mostafaaabedia-tech/earthquake/firmware/earthquake_esp32/earthquake_esp32.ino

/*
  ============================================================================
   QuakeGuard v2  —  Earthquake Detection & Building Evacuation  (ESP32 + MPU6050)
  ============================================================================
   When the MPU6050 senses an earthquake:
     • both buzzers sound (siren)          • the warning LED turns on
     • the servo opens the exit door       • the relay turns on the emergency light
     • the event goes to Firebase and the GitHub web page (QuakeGuard dashboard)
     • optional: a Telegram and/or ntfy.sh message is sent to your phone

   Detection (v2)
     STA/LTA trigger, as used by real seismographs: the 1-second average of the
     vibration (STA) is compared with the 30-second background level (LTA).
     An alarm needs:  ratio >= trigger  AND  vibration >= minimum g
                      for at least the minimum duration (rejects door slams).
     Very strong shaking or fast rotation (gyroscope) also triggers it.

   Behaviour
     MONITORING -> earthquake, or dangerous air (MQ-2 / MQ-135) -> ALARM
     ALARM      -> calm for the quiet time                     -> HOLD
                   (buzzers off; LED, door and light stay on so people can leave)
     ALARM/HOLD -> reset button or "Reset alarm" on the page   -> MONITORING
     After a real earthquake, a 24-hour AFTERSHOCK WATCH lowers the threshold.

   The web page can change the detection settings, run tests, calibrate the
   sensor and end the aftershock watch. All of it is read from Firebase.

   The alarm runs on core 1 and never waits for the internet.
   Wi-Fi, Firebase and alerts run on core 0.

   Libraries: ESP32Servo (Kevin Harrington), U8g2 (oliver) for the OLED.   Board: "ESP32 Dev Module".
  ============================================================================
*/

#include <WiFi.h>
#include <WiFiClientSecure.h>
#include <HTTPClient.h>
#include <Wire.h>
#include <ESP32Servo.h>
#include <math.h>
#include <U8g2lib.h>
#include <WebServer.h>
#include <ESPmDNS.h>
#include <Preferences.h>
#include <BLEDevice.h>
#include <BLEServer.h>
#include <BLE2902.h>

// ============================ USER SETTINGS =================================
// Wi-Fi: easiest is the web page -> Settings -> "Set up Wi-Fi by Bluetooth".
// The name and password are then saved in the ESP32 and used after every restart.
// You can still type them here instead (used only when nothing is saved).
// To forget the saved Wi-Fi: hold the RESET button while powering on.
// IMPORTANT: Arduino IDE -> Tools -> Partition Scheme -> "Huge APP (3MB No OTA/1MB SPIFFS)"
const char* WIFI_SSID     = "YOUR_WIFI_NAME";
const char* WIFI_PASSWORD = "YOUR_WIFI_PASSWORD";
const unsigned long BLE_OFF_AFTER_MS = 300000;   // Bluetooth turns off 5 min after Wi-Fi connects (frees memory)

// Firebase Realtime Database URL, without a trailing slash
const char* FIREBASE_URL  = "https://quakeguard-earthquake-default-rtdb.europe-west1.firebasedatabase.app";
const char* FIREBASE_AUTH = "";            // database secret, or empty (see README)

// One database path per floor. Floor 1 = "/earthquake", floor 2 = "/floor2"...
// It must match the "path" of the floor in the web page's config.js.
const char* DB_PATH       = "/earthquake";
const char* FLOOR_NAME    = "Floor 1";

// ---------------- Optional phone alerts (leave empty to switch off) --------
// Telegram: create a bot with @BotFather, press "Start" on it, then put the
// bot token and your chat id here (see README).
const char* TELEGRAM_BOT_TOKEN = "";
const char* TELEGRAM_CHAT_ID   = "";
// ntfy.sh: install the ntfy app and subscribe to a long, secret topic name.
const char* NTFY_TOPIC         = "";

// ------------------------------ Pins ---------------------------------------
const int PIN_SDA        = 21;   // MPU6050 SDA
const int PIN_SCL        = 22;   // MPU6050 SCL
const int PIN_BUZZER_1   = 25;   // active buzzer 1
const int PIN_BUZZER_2   = 26;   // active buzzer 2
const int PIN_LED        = 27;   // warning LED (through 220 ohm resistor)
const int PIN_SERVO      = 13;   // door servo signal
const int PIN_RELAY      = 14;   // relay IN (emergency / corridor light)
const int PIN_RESET_BTN  = 4;    // push button to GND
const int PIN_MQ2        = 34;   // MQ-2  AO  (LPG + smoke)   through a divider 5V -> 3.3V
const int PIN_MQ135      = 35;   // MQ-135 AO (CO2 / bad air) through a divider 5V -> 3.3V

const bool AIR_SENSORS_INSTALLED = true;  // MQ-2 + MQ-135 fitted (false = earthquake only)
const bool RELAY_ACTIVE_LOW     = true;   // your relay: LOW = ON, HIGH = OFF (tested with the relay test sketch)
const bool RELAY_BOOT_TEST      = true;   // relay test at power-up, so you can see it works
const int  RELAY_TEST_TIMES     = 3;      // how many ON/OFF clicks (1 s ON, 1 s OFF each)
// AUTO relay: only for a STRONG earthquake, and only for a while.
//   relayMinG  : shaking must reach this peak (g) before the light turns on (0.06 g = intensity V)
//   relayHold  : the light turns OFF this many seconds after the shaking stops
// Both can also be changed on the web page (Settings -> Detector settings).

const int DOOR_CLOSED_ANGLE = 0;
const int DOOR_OPEN_ANGLE   = 90;

// Default detection settings. The web page can change them (Settings tab).
struct Settings {
  float    minG;       // minimum vibration for an earthquake (g)
  float    staTrig;    // STA/LTA trigger ratio
  float    staDetrig;  // STA/LTA detrigger ratio
  float    gyroDps;    // rotation that also counts as shaking (deg/s)
  uint32_t minDurMs;   // shaking must last this long (ms)
  uint32_t quietMs;    // calm time before buzzers stop (ms)
  float    lpgLimit;   // LPG estimate (ppm) for a gas alarm
  float    smokeLimit; // smoke estimate (ppm)
  float    co2Limit;   // CO2 estimate (ppm)
  float    relayMinG;  // light relay: minimum peak shaking (g)
  uint32_t relayHoldMs;// light relay: stays on this long after the alarm ends
};
Settings cfg = { 0.03f, 3.0f, 1.5f, 25.0f, 800, 15000, 600.0f, 300.0f, 1500.0f, 0.06f, 20000 };

const unsigned long TEST_MS          = 6000;          // test alarm length
const unsigned long RESET_IGNORE_MS  = 2000;          // ignore shaking after reset
const unsigned long DOOR_IGNORE_MS   = 1500;          // ignore shaking while servo moves
const unsigned long MAX_QUAKE_MS     = 120000;        // buzzers stop after 2 min anyway
const unsigned long AFTERSHOCK_MS    = 24UL * 3600000UL; // 24 h aftershock watch
const float         AFTERSHOCK_FACTOR = 0.7f;         // threshold x0.7 during the watch
const unsigned long GAS_WARMUP_MS    = 60000;         // MQ sensor heater warm-up
const unsigned long GAS_CONFIRM_MS   = 2000;
const unsigned long CONFIG_PERIOD_MS = 15000;         // read settings from Firebase

// ------------------------------ OLED ---------------------------------------
// I2C OLED on the same pins as the MPU6050 (SDA 21, SCL 22). Pick your model:
//   1 = 0.96" SSD1306 128x64   2 = 1.3" SH1106 128x64
//   3 = 1.5" SH1107 128x128 (most blue 4-pin boards)
//   4 = 1.5" SH1107 128x128, other type: use it if the picture is shifted or cut with 3
#define OLED_MODEL 3
const bool OLED_ENABLED = true;      // false if no OLED is connected
const unsigned long OLED_PAGE_MS = 5000;   // time per page while monitoring

const bool DEBUG_SERIAL = true;
const char* FW_VERSION  = "2.1";

// Name on the local network: http://quakeguard.local (floor 2: "quakeguard-2" ...)
const char* MDNS_NAME   = "quakeguard";
// ============================================================================

// MPU6050
const uint8_t MPU_ADDR = 0x68;
const float ACCEL_LSB_PER_G  = 16384.0f;   // +/-2 g
const float GYRO_LSB_PER_DPS = 131.0f;     // +/-250 deg/s

const unsigned long SAMPLE_PERIOD_MS = 10;  // 100 Hz
const unsigned long TRACE_WINDOW_MS  = 100; // 10 seismograph points per second
const float STA_ALPHA     = 1.0f / 100.0f;  // 1 s at 100 Hz
const float LTA_ALPHA     = 1.0f / 3000.0f; // 30 s at 100 Hz
const float NOISE_FLOOR_G = 0.002f;         // MPU6050 noise floor

enum State : uint8_t { ST_CALIBRATING = 0, ST_MONITOR, ST_ALARM, ST_HOLD };
const char* STATE_NAMES[] = { "CALIBRATING", "MONITORING", "ALARM", "HOLD" };
enum Kind : uint8_t { K_QUAKE = 0, K_FIRE = 1 };

// --------------------------- Shared data ------------------------------------
portMUX_TYPE dataMux = portMUX_INITIALIZER_UNLOCKED;

struct LiveData {
  State state;
  bool  quake, fire, test, latched;
  float shake, gyro, sta, ratio, peak, peakAll, tilt;
  float lpg, smoke, co2, airRatio;
  int   mq2Raw, mq135Raw;
  bool  gasWarm, silenced, buzzer, led, light, doorOpen, sensorOk;
  uint32_t quakes, fires, aftershocks;
  long  watchLeftS;
};
LiveData live = {};

const int TRACE_LEN = 64;
float    traceRing[TRACE_LEN];
uint32_t traceSeq = 0;

// Event messages: sensor loop -> network task
struct EvMsg { uint8_t type; uint8_t kind; bool test; float peak; float dur; float lpg, smoke, co2; };
enum { EV_START = 0, EV_END = 1 };
const int EVQ_LEN = 16;
EvMsg    evq[EVQ_LEN];
volatile uint32_t evHead = 0;

volatile uint32_t resetCount = 0;

// Commands from the web page
volatile bool cmdReset = false, cmdTest = false, cmdTestFire = false;
volatile bool cmdCalibrate = false, cmdEndWatch = false, cmdSilence = false;
volatile int  cmdRelay = -1;          // new relay mode from the page / Serial / local page

// Light relay mode: AUTO = on during an alarm (normal), ON / OFF = forced,
// TEST = 2 s ON, 2 s OFF, exactly like the relay test sketch.
enum RelayMode : uint8_t { RM_AUTO = 0, RM_ON, RM_OFF, RM_TEST };
const char* RELAY_MODES[] = { "auto", "on", "off", "test" };
volatile RelayMode relayMode = RM_AUTO;
volatile bool relayOn = false;

// --------------------------- Sensor state -----------------------------------
Servo doorServo;
#if OLED_MODEL == 2
U8G2_SH1106_128X64_NONAME_F_HW_I2C oled(U8G2_R0, U8X8_PIN_NONE);
#elif OLED_MODEL == 3
U8G2_SH1107_SEEED_128X128_F_HW_I2C oled(U8G2_R0, U8X8_PIN_NONE);
#elif OLED_MODEL == 4
U8G2_SH1107_128X128_F_HW_I2C oled(U8G2_R0, U8X8_PIN_NONE);
#else
U8G2_SSD1306_128X64_NONAME_F_HW_I2C oled(U8G2_R0, U8X8_PIN_NONE);
#endif
bool oledOk = false;
volatile bool cloudOk = false;       // last Firebase upload worked
void oledCalib(int pct);             // drawn while calibrating
void pushWave(float v);
float baseX = 0, baseY = 0, baseZ = 1;          // current gravity vector
float calX = 0, calY = 0, calZ = 1;             // gravity at calibration (tilt reference)
float gyroOffX = 0, gyroOffY = 0, gyroOffZ = 0;
float shakeAvg = 0, gyroAvg = 0, shakeFast = 0;
float sta = 0, lta = NOISE_FLOOR_G;
bool  sensorOk = false;
bool  doorIsOpen = false;

bool quakeActive = false, fireActive = false, testActive = false, latched = false;
uint8_t testKind = K_QUAKE;
unsigned long trigStartMs = 0, quakeStartMs = 0, lastShakeMs = 0;
unsigned long fireCondMs = 0, fireStartMs = 0, lastFireMs = 0;
unsigned long testStartMs = 0, testEndMs = 0;
unsigned long ignoreUntilMs = 0, watchUntilMs = 0;
float quakePeak = 0, peakAll = 0;
float lpg = 0, smoke = 0, co2 = 400, airRatio = 0;      // air quality estimates (ppm)
int   mq2Raw = 0, mq135Raw = 0;
float peakLpg = 0, peakSmoke = 0, peakCo2 = 0;          // worst air during a gas alarm
bool  silenced = false;                                 // buzzers silenced from the page
bool  lastWasFire = false;                              // cause of the last real alarm (for the OLED)
uint32_t quakeCount = 0, fireCount = 0, aftershockCount = 0;
float windowMax = 0;
unsigned long windowStartMs = 0;

// ============================================================================
//                                MPU6050
// ============================================================================
void mpuWrite(uint8_t reg, uint8_t val) {
  Wire.beginTransmission(MPU_ADDR);
  Wire.write(reg);
  Wire.write(val);
  Wire.endTransmission();
}

bool mpuBegin() {
  Wire.begin(PIN_SDA, PIN_SCL);
  Wire.setClock(400000);
  Wire.beginTransmission(MPU_ADDR);
  if (Wire.endTransmission() != 0) return false;
  mpuWrite(0x6B, 0x00);  // wake up
  delay(100);
  mpuWrite(0x1A, 0x03);  // low-pass filter ~44 Hz
  mpuWrite(0x1B, 0x00);  // gyro +/-250 deg/s
  mpuWrite(0x1C, 0x00);  // accel +/-2 g
  return true;
}

bool mpuRead(float& ax, float& ay, float& az, float& gx, float& gy, float& gz) {
  Wire.beginTransmission(MPU_ADDR);
  Wire.write(0x3B);
  if (Wire.endTransmission(false) != 0) return false;
  if (Wire.requestFrom((int)MPU_ADDR, 14) != 14) return false;
  int16_t raw[7];
  for (int i = 0; i < 7; i++) raw[i] = (int16_t)((Wire.read() << 8) | Wire.read());
  ax = raw[0] / ACCEL_LSB_PER_G;  ay = raw[1] / ACCEL_LSB_PER_G;  az = raw[2] / ACCEL_LSB_PER_G;
  gx = raw[4] / GYRO_LSB_PER_DPS; gy = raw[5] / GYRO_LSB_PER_DPS; gz = raw[6] / GYRO_LSB_PER_DPS;
  return true;
}

// Keep the sensor still for about 2 seconds.
void calibrate() {
  portENTER_CRITICAL(&dataMux); live.state = ST_CALIBRATING; portEXIT_CRITICAL(&dataMux);
  Serial.println("Calibrating... keep the sensor still.");
  for (int attempt = 0; attempt < 5; attempt++) {
    const int N = 200;
    static float bx[N], by[N], bz[N];
    float sx = 0, sy = 0, sz = 0, sgx = 0, sgy = 0, sgz = 0;
    int good = 0;
    for (int i = 0; i < N; i++) {
      float x, y, z, gx, gy, gz;
      if (mpuRead(x, y, z, gx, gy, gz)) {
        bx[good] = x; by[good] = y; bz[good] = z;
        sx += x; sy += y; sz += z; sgx += gx; sgy += gy; sgz += gz;
        good++;
      }
      digitalWrite(PIN_LED, (i / 20) % 2);
      if (i % 20 == 0) oledCalib(i * 100 / N);
      delay(SAMPLE_PERIOD_MS);
    }
    if (good < N / 2) continue;
    baseX = sx / good; baseY = sy / good; baseZ = sz / good;
    gyroOffX = sgx / good; gyroOffY = sgy / good; gyroOffZ = sgz / good;
    float noise = 0;
    for (int i = 0; i < good; i++) {
      float dx = bx[i] - baseX, dy = by[i] - baseY, dz = bz[i] - baseZ;
      noise += sqrtf(dx * dx + dy * dy + dz * dz);
    }
    noise /= good;
    Serial.printf("Calibration noise: %.4f g\n", noise);
    lta = fmaxf(noise, NOISE_FLOOR_G);
    if (noise < 0.02f) break;
    Serial.println("Too much movement, calibrating again...");
  }
  calX = baseX; calY = baseY; calZ = baseZ;
  digitalWrite(PIN_LED, LOW);
  shakeAvg = gyroAvg = shakeFast = 0;
  sta = 0;
}

float tiltDegrees() {
  float n1 = sqrtf(calX * calX + calY * calY + calZ * calZ);
  float n2 = sqrtf(baseX * baseX + baseY * baseY + baseZ * baseZ);
  if (n1 < 0.1f || n2 < 0.1f) return 0;
  float c = (calX * baseX + calY * baseY + calZ * baseZ) / (n1 * n2);
  c = fminf(1.0f, fmaxf(-1.0f, c));
  return acosf(c) * 57.2958f;
}

// Modified Mercalli intensity from peak acceleration (Worden et al. 2012)
float mmiFromG(float g) {
  float L = log10f(fmaxf(g * 980.665f, 0.01f));
  float m = (L <= 1.57f) ? 1.78f + 1.55f * L : -1.60f + 3.70f * L;
  return fminf(10.0f, fmaxf(1.0f, m));
}
const char* ROMAN[] = { "I", "I", "II", "III", "IV", "V", "VI", "VII", "VIII", "IX", "X" };

// ============================================================================
//                               Outputs
// ============================================================================
// Same as the relay test sketch: active-low relay -> digitalWrite(LOW) = ON, digitalWrite(HIGH) = OFF
void setRelay(bool on) {
  if (RELAY_ACTIVE_LOW) digitalWrite(PIN_RELAY, on ? LOW : HIGH);
  else                  digitalWrite(PIN_RELAY, on ? HIGH : LOW);
  if (on != relayOn) Serial.println(on ? "Relay ON  (LOW)" : "Relay OFF (HIGH)");
  relayOn = on;
}
int relayModeFrom(const String& c) {
  if (c.indexOf("auto") >= 0) return RM_AUTO;
  if (c.indexOf("test") >= 0) return RM_TEST;
  if (c.indexOf("off") >= 0)  return RM_OFF;
  if (c.indexOf("on") >= 0)   return RM_ON;
  return -1;
}
void setBuzzers(bool on) { digitalWrite(PIN_BUZZER_1, on); digitalWrite(PIN_BUZZER_2, on); }

void setDoor(bool open, unsigned long now) {
  if (open == doorIsOpen) return;
  doorServo.write(open ? DOOR_OPEN_ANGLE : DOOR_CLOSED_ANGLE);
  doorIsOpen = open;
  ignoreUntilMs = max(ignoreUntilMs, now + DOOR_IGNORE_MS);   // servo vibration is not a quake
}

State currentState() {
  if (quakeActive || fireActive || testActive) return ST_ALARM;
  if (latched) return ST_HOLD;
  return ST_MONITOR;
}

// ============================================================================
//                              Events
// ============================================================================
void pushEvent(uint8_t type, uint8_t kind, bool test, float peak, float dur, float l = 0, float sm = 0, float c2 = 0) {
  portENTER_CRITICAL(&dataMux);
  evq[evHead % EVQ_LEN] = { type, kind, test, peak, dur, l, sm, c2 };
  evHead = evHead + 1;
  portEXIT_CRITICAL(&dataMux);
}

void endTest(unsigned long now) {
  if (!testActive) return;
  testActive = false;
  pushEvent(EV_END, testKind, true, 0, (now - testStartMs) / 1000.0f);
}

void startQuake(unsigned long now) {
  endTest(now);
  quakeActive = true;
  latched = true;
  lastWasFire = false;
  quakeStartMs = lastShakeMs = now;
  quakePeak = shakeFast;
  quakeCount++;
  if ((long)(watchUntilMs - now) > 0) aftershockCount++;
  silenced = false;
  pushEvent(EV_START, K_QUAKE, false, quakePeak, 0);
  Serial.println(">>> EARTHQUAKE DETECTED — ALARM ON");
}

void endQuake(unsigned long now) {
  if (!quakeActive) return;
  quakeActive = false;
  pushEvent(EV_END, K_QUAKE, false, quakePeak, (lastShakeMs - quakeStartMs) / 1000.0f);
  watchUntilMs = now + AFTERSHOCK_MS;
  Serial.println(">>> Shaking stopped — aftershock watch started (24 h)");
}

void startFire(unsigned long now) {
  endTest(now);
  fireActive = true;
  latched = true;
  lastWasFire = true;
  fireStartMs = lastFireMs = now;
  peakLpg = lpg; peakSmoke = smoke; peakCo2 = co2;
  silenced = false;
  fireCount++;
  pushEvent(EV_START, K_FIRE, false, 0, 0, lpg, smoke, co2);
  Serial.println(">>> GAS / FIRE DETECTED — ALARM ON");
}

void endFire(unsigned long now) {
  if (!fireActive) return;
  fireActive = false;
  pushEvent(EV_END, K_FIRE, false, 0, (lastFireMs - fireStartMs) / 1000.0f, peakLpg, peakSmoke, peakCo2);
}

void startTest(unsigned long now, uint8_t kind) {
  if (currentState() != ST_MONITOR) return;
  testActive = true;
  testKind = kind;
  testStartMs = now;
  testEndMs = now + TEST_MS;
  silenced = false;
  pushEvent(EV_START, kind, true, 0, 0);
  Serial.println(kind == K_FIRE ? ">>> FIRE TEST" : ">>> EARTHQUAKE TEST");
}

void resetSystem(unsigned long now) {
  endQuake(now);
  endFire(now);
  endTest(now);
  latched = false;
  trigStartMs = 0;
  fireCondMs = 0;
  ignoreUntilMs = now + RESET_IGNORE_MS;
  resetCount = resetCount + 1;
  Serial.println(">>> System reset — monitoring");
}

// ============================================================================
//                    Network task (core 0)
// ============================================================================
WiFiClientSecure secureClient;

bool cloudConfigured() {
  return strstr(FIREBASE_URL, "YOUR-PROJECT") == nullptr;
}

String fbUrl(const String& path) {
  String url = String(FIREBASE_URL) + DB_PATH + path + ".json";
  if (strlen(FIREBASE_AUTH) > 0) url += "?auth=" + String(FIREBASE_AUTH);
  return url;
}

int fbRequest(const char* method, const String& path, const String& body, String* response) {
  HTTPClient http;
  http.setTimeout(6000);
  if (!http.begin(secureClient, fbUrl(path))) return -1;
  http.addHeader("Content-Type", "application/json");
  int code = (strcmp(method, "GET") == 0) ? http.GET() : http.sendRequest(method, body);
  if (response && code > 0) *response = http.getString();
  http.end();
  return code;
}

String urlEncode(const String& s) {
  String out;
  const char* hex = "0123456789ABCDEF";
  for (size_t i = 0; i < s.length(); i++) {
    uint8_t c = s[i];
    if (isalnum(c) || c == '-' || c == '_' || c == '.' || c == '~') out += (char)c;
    else { out += '%'; out += hex[c >> 4]; out += hex[c & 15]; }
  }
  return out;
}

void sendAlert(const String& title, const String& text) {
  if (strlen(TELEGRAM_BOT_TOKEN) > 0 && strlen(TELEGRAM_CHAT_ID) > 0) {
    HTTPClient http;
    http.setTimeout(8000);
    String url = String("https://api.telegram.org/bot") + TELEGRAM_BOT_TOKEN +
                 "/sendMessage?chat_id=" + TELEGRAM_CHAT_ID + "&text=" + urlEncode(title + "\n" + text);
    if (http.begin(secureClient, url)) { http.GET(); http.end(); }
  }
  if (strlen(NTFY_TOPIC) > 0) {
    HTTPClient http;
    http.setTimeout(8000);
    if (http.begin(secureClient, String("https://ntfy.sh/") + NTFY_TOPIC)) {
      http.addHeader("Title", title);
      http.addHeader("Priority", "urgent");
      http.addHeader("Tags", "warning,rotating_light");
      http.POST(text);
      http.end();
    }
  }
}

// Reads  "key": number  from a small JSON text.
bool jsonNumber(const String& s, const char* key, float& out) {
  String k = String("\"") + key + "\":";
  int p = s.indexOf(k);
  if (p < 0) return false;
  p += k.length();
  while (p < (int)s.length() && s[p] == ' ') p++;
  int q = p;
  while (q < (int)s.length() && (isdigit(s[q]) || s[q] == '.' || s[q] == '-' || s[q] == 'e' || s[q] == 'E' || s[q] == '+')) q++;
  if (q == p) return false;
  out = s.substring(p, q).toFloat();
  return true;
}

String settingsJson(const Settings& c) {
  return String("{\"minG\":") + String(c.minG, 3) +
         ",\"staTrig\":" + String(c.staTrig, 2) +
         ",\"staDetrig\":" + String(c.staDetrig, 2) +
         ",\"gyroDps\":" + String(c.gyroDps, 1) +
         ",\"minDur\":" + String(c.minDurMs / 1000.0f, 2) +
         ",\"quiet\":" + String(c.quietMs / 1000.0f, 1) +
         ",\"lpgLimit\":" + String(c.lpgLimit, 0) + ",\"smokeLimit\":" + String(c.smokeLimit, 0) +
         ",\"co2Limit\":" + String(c.co2Limit, 0) +
         ",\"relayMinG\":" + String(c.relayMinG, 3) + ",\"relayHold\":" + String(c.relayHoldMs / 1000.0f, 0) + "}";
}

void readConfig() {
  String resp;
  if (fbRequest("GET", "/config", "", &resp) != 200) return;
  Settings c;
  portENTER_CRITICAL(&dataMux); c = cfg; portEXIT_CRITICAL(&dataMux);
  if (resp == "null") {                         // first start: publish defaults
    fbRequest("PUT", "/config", settingsJson(c), nullptr);
    return;
  }
  float v;
  if (jsonNumber(resp, "minG", v)      && v >= 0.005f && v <= 1.5f)  c.minG = v;
  if (jsonNumber(resp, "staTrig", v)   && v >= 1.2f   && v <= 20)    c.staTrig = v;
  if (jsonNumber(resp, "staDetrig", v) && v >= 1.0f   && v <= 10)    c.staDetrig = v;
  if (jsonNumber(resp, "gyroDps", v)   && v >= 5      && v <= 250)   c.gyroDps = v;
  if (jsonNumber(resp, "minDur", v)    && v >= 0.1f   && v <= 10)    c.minDurMs = (uint32_t)(v * 1000);
  if (jsonNumber(resp, "quiet", v)     && v >= 3      && v <= 600)   c.quietMs = (uint32_t)(v * 1000);
  if (jsonNumber(resp, "lpgLimit", v)   && v >= 50  && v <= 1000) c.lpgLimit = v;
  if (jsonNumber(resp, "smokeLimit", v) && v >= 50  && v <= 800)  c.smokeLimit = v;
  if (jsonNumber(resp, "co2Limit", v)   && v >= 450 && v <= 2000) c.co2Limit = v;
  if (jsonNumber(resp, "relayMinG", v)  && v >= 0   && v <= 2)    c.relayMinG = v;
  if (jsonNumber(resp, "relayHold", v)  && v >= 0   && v <= 3600) c.relayHoldMs = (uint32_t)(v * 1000);
  if (c.staDetrig >= c.staTrig) c.staDetrig = c.staTrig * 0.6f;
  portENTER_CRITICAL(&dataMux); cfg = c; portEXIT_CRITICAL(&dataMux);
}

const char* kindName(uint8_t k) { return k == K_FIRE ? "fire" : "quake"; }

// ============================================================================
//            Local page + "find stations" (works on the same Wi-Fi)
// ============================================================================
WebServer server(80);
String stationId;
volatile bool mdnsOk = false;

String infoJson() {
  LiveData s; Settings c;
  portENTER_CRITICAL(&dataMux); s = live; c = cfg; portEXIT_CRITICAL(&dataMux);
  auto b = [](bool v) { return v ? "true" : "false"; };
  return String("{\"app\":\"quakeguard\",\"id\":\"") + stationId + "\",\"name\":\"" + FLOOR_NAME +
    "\",\"path\":\"" + DB_PATH + "\",\"fw\":\"" + FW_VERSION + "\",\"ip\":\"" + WiFi.localIP().toString() +
    "\",\"mdns\":\"" + MDNS_NAME + ".local\",\"rssi\":" + String(WiFi.RSSI()) + ",\"uptime\":" + String(millis() / 1000) +
    ",\"state\":\"" + STATE_NAMES[s.state] + "\",\"quake\":" + b(s.quake) + ",\"fire\":" + b(s.fire) +
    ",\"shake\":" + String(s.shake, 4) + ",\"tilt\":" + String(s.tilt, 2) +
    ",\"lpg\":" + String(s.lpg, 0) + ",\"smoke\":" + String(s.smoke, 0) + ",\"co2\":" + String(s.co2, 0) +
    ",\"door\":\"" + (s.doorOpen ? "open" : "closed") + "\",\"light\":" + b(s.light) + ",\"relayMode\":\"" + RELAY_MODES[relayMode] + "\"" +
    ",\"sensorOk\":" + b(s.sensorOk) + ",\"cloud\":" + b(cloudOk) + "}";
}

const char LOCAL_PAGE[] PROGMEM =
  "<!doctype html><html lang=\"en\"><head><meta charset=\"utf-8\">\n"
  "<meta name=\"viewport\" content=\"width=device-width,initial-scale=1\"><title>QuakeGuard station</title>\n"
  "<style>body{margin:0;font:16px/1.45 system-ui,sans-serif;background:#050d1a;color:#e6f0fb;padding:20px}\n"
  "main{max-width:520px;margin:0 auto}h1{font-size:1.4rem;margin:0 0 4px}.m{color:#7f98b4;margin:0 0 16px}\n"
  ".st{padding:16px;border-radius:14px;border:1px solid #1de9b6;background:#0b3a33;font-weight:800;font-size:1.5rem;color:#1de9b6}\n"
  ".st.a{border-color:#ffb020;background:#2a2110;color:#ffb020}.st.f{border-color:#ff5a3c;background:#2c1511;color:#ff5a3c}\n"
  "dl{display:grid;grid-template-columns:1fr auto;gap:10px;margin:16px 0;padding:14px;border:1px solid #1a3552;border-radius:14px;background:#0a1a2e}\n"
  "dt{color:#7f98b4}dd{margin:0;font-weight:600;text-align:right}button{width:100%;min-height:48px;margin-top:8px;border-radius:10px;border:0;font:600 1rem system-ui;background:#1de9b6;color:#04251d}\n"
  "button.s{background:#0a1a2e;color:#e6f0fb;border:1px solid #1a3552}a{color:#1de9b6}</style></head><body><main>\n"
  "<h1>QuakeGuard station</h1><p class=\"m\" id=\"n\">Connecting…</p><div class=\"st\" id=\"st\">…</div>\n"
  "<dl><dt>Vibration</dt><dd id=\"v\">-</dd><dt>Tilt</dt><dd id=\"t\">-</dd><dt>LPG / smoke / CO₂</dt><dd id=\"g\">-</dd>\n"
  "<dt>Exit door</dt><dd id=\"d\">-</dd><dt>Wi-Fi signal</dt><dd id=\"r\">-</dd><dt>Cloud (Firebase)</dt><dd id=\"c\">-</dd><dt>Running for</dt><dd id=\"u\">-</dd></dl>\n"
  "<p class=\"m\" style=\"margin:16px 0 4px\">Light relay: <b id=\"rm\">-</b></p><div style=\"display:grid;grid-template-columns:repeat(4,1fr);gap:6px\"><button class=\"s\" onclick=\"cmd('relay_auto')\">Auto</button><button class=\"s\" onclick=\"cmd('relay_on')\">On</button><button class=\"s\" onclick=\"cmd('relay_off')\">Off</button><button class=\"s\" onclick=\"cmd('relay_test')\">Test</button></div>\n"
  "<button onclick=\"cmd('silence')\">Silence buzzers</button><button class=\"s\" onclick=\"if(confirm('Reset only when the area is safe. Reset now?'))cmd('reset')\">Reset alarm</button>\n"
  "<p class=\"m\">This page comes straight from the ESP32 and works on the same Wi-Fi without internet. Full dashboard: <a href=\"https://mostafaaabedia-tech.github.io/earthquake/\">QuakeGuard</a></p>\n"
  "</main><script>\n"
  "const $=i=>document.getElementById(i);\n"
  "async function up(){try{const d=await(await fetch('/info',{cache:'no-store'})).json();\n"
  "$('n').textContent=d.name+' · '+d.ip+' · '+d.mdns+' · v'+d.fw;\n"
  "const a=d.state=='ALARM',h=d.state=='HOLD';$('st').className='st'+(a&&d.fire?' f':a||h?' a':'');\n"
  "$('st').textContent=a?(d.fire?'DANGEROUS AIR':'EARTHQUAKE'):h?'ALARM HOLD – reset when safe':d.sensorOk?'All clear':'Motion sensor not found';\n"
  "$('v').textContent=d.shake.toFixed(3)+' g';$('t').textContent=d.tilt.toFixed(2)+'°';$('g').textContent=d.lpg+' / '+d.smoke+' / '+d.co2+' ppm';\n"
  "$('d').textContent=d.door;$('r').textContent=d.rssi+' dBm';$('c').textContent=d.cloud?'online':'offline';$('rm').textContent=(d.relayMode||'auto')+(d.light?' · ON':' · OFF');\n"
  "const s=d.uptime;$('u').textContent=Math.floor(s/3600)+' h '+Math.floor(s%3600/60)+' min';}catch(e){$('n').textContent='Station not reachable';}}\n"
  "async function cmd(c){await fetch('/cmd?c='+c,{method:'POST'});up();}\n"
  "up();setInterval(up,1000);</script></body></html>\n";

void sendCors() { server.sendHeader("Access-Control-Allow-Origin", "*"); server.sendHeader("Cache-Control", "no-store"); }

void serverTask(void*) {
  server.on("/", HTTP_GET, []() { sendCors(); server.send_P(200, "text/html; charset=utf-8", LOCAL_PAGE); });
  server.on("/info", HTTP_GET, []() { sendCors(); server.send(200, "application/json", infoJson()); });
  server.on("/cmd", HTTP_POST, []() {
    String c = server.arg("c");
    if (c.startsWith("relay")) cmdRelay = relayModeFrom(c);
    else if (c == "silence") cmdSilence = true; else if (c == "reset") cmdReset = true;
    sendCors(); server.send(200, "application/json", "{\"ok\":true}");
  });
  server.onNotFound([]() { sendCors(); server.send(404, "text/plain", "Not found"); });
  bool started = false;
  for (;;) {
    if (WiFi.status() == WL_CONNECTED) {
      if (!started) {
        server.begin(); started = true;
        mdnsOk = MDNS.begin(MDNS_NAME);
        if (mdnsOk) { MDNS.addService("http", "tcp", 80); MDNS.addServiceTxt("http", "tcp", "app", "quakeguard"); }
        Serial.printf("Local page: http://%s/  or  http://%s.local/\n", WiFi.localIP().toString().c_str(), MDNS_NAME);
      }
      server.handleClient();
    }
    vTaskDelay(pdMS_TO_TICKS(5));
  }
}

// Announce this station in the shared Firebase list, so the dashboard's
// "Find stations" can see it from anywhere (every 30 s).
void announceStation() {
  HTTPClient http;
  http.setTimeout(6000);
  String url = String(FIREBASE_URL) + "/earthquake/stations/" + stationId + ".json";
  if (strlen(FIREBASE_AUTH) > 0) url += "?auth=" + String(FIREBASE_AUTH);
  if (!http.begin(secureClient, url)) return;
  http.addHeader("Content-Type", "application/json");
  String body = infoJson();
  body.remove(body.length() - 1);
  body += ",\"lastSeen\":{\".sv\":\"timestamp\"}}";
  http.PUT(body);
  http.end();
}

// ============================================================================
//                Wi-Fi setup over Bluetooth (from the web page)
// ============================================================================
// The page connects with Web Bluetooth (Chrome / Edge on Android, Windows, Mac),
// asks the ESP32 to scan for Wi-Fi networks, then sends the name + password.
#define BLE_SVC   "7a1e0001-4f3c-4c1e-9b5e-5c0a9e8d1a00"
#define BLE_SSID  "7a1e0002-4f3c-4c1e-9b5e-5c0a9e8d1a00"   // write: network name
#define BLE_PASS  "7a1e0003-4f3c-4c1e-9b5e-5c0a9e8d1a00"   // write: password
#define BLE_CMD   "7a1e0004-4f3c-4c1e-9b5e-5c0a9e8d1a00"   // write: "connect" | "scan" | "forget"
#define BLE_STAT  "7a1e0005-4f3c-4c1e-9b5e-5c0a9e8d1a00"   // read/notify: status JSON
#define BLE_NETS  "7a1e0006-4f3c-4c1e-9b5e-5c0a9e8d1a00"   // read/notify: networks JSON
#define BLE_INFO  "7a1e0007-4f3c-4c1e-9b5e-5c0a9e8d1a00"   // read: station info JSON

Preferences wifiPrefs;
String wifiSsid, wifiPass;              // the Wi-Fi in use
String pendSsid, pendPass;              // received over Bluetooth
volatile bool bleConnectReq = false, bleScanReq = false, bleForgetReq = false;
volatile bool bleOn = false;
BLEServer* bleServer = nullptr;
BLECharacteristic *chStat = nullptr, *chNets = nullptr;

void bleStatus(const char* st, const String& extra = "") {
  if (!bleOn || !chStat) return;
  String j = String("{\"st\":\"") + st + "\",\"ssid\":\"" + wifiSsid + "\",\"ip\":\"" +
             (WiFi.status() == WL_CONNECTED ? WiFi.localIP().toString() : String("")) + "\"" + extra + "}";
  chStat->setValue(j);
  chStat->notify();
}

class BleSrvCb : public BLEServerCallbacks {
  void onConnect(BLEServer*) override { Serial.println("Bluetooth: phone connected"); }
  void onDisconnect(BLEServer*) override { Serial.println("Bluetooth: phone disconnected"); delay(200); BLEDevice::startAdvertising(); }
};
class BleWriteCb : public BLECharacteristicCallbacks {
  void onWrite(BLECharacteristic* c) override {
    String v = c->getValue();
    String u = c->getUUID().toString().c_str();
    if (u == BLE_SSID) pendSsid = v;
    else if (u == BLE_PASS) pendPass = v;
    else if (u == BLE_CMD) {
      v.trim();
      if (v == "connect") bleConnectReq = true;
      else if (v == "scan") bleScanReq = true;
      else if (v == "forget") bleForgetReq = true;
    }
  }
};

void startBle() {
  String name = "QuakeGuard-" + stationId.substring(stationId.length() - 4);
  BLEDevice::init(name.c_str());
  bleServer = BLEDevice::createServer();
  bleServer->setCallbacks(new BleSrvCb());
  BLEService* svc = bleServer->createService(BLEUUID(BLE_SVC), 32);
  auto* wcb = new BleWriteCb();
  svc->createCharacteristic(BLE_SSID, BLECharacteristic::PROPERTY_WRITE)->setCallbacks(wcb);
  svc->createCharacteristic(BLE_PASS, BLECharacteristic::PROPERTY_WRITE)->setCallbacks(wcb);
  svc->createCharacteristic(BLE_CMD,  BLECharacteristic::PROPERTY_WRITE)->setCallbacks(wcb);
  chStat = svc->createCharacteristic(BLE_STAT, BLECharacteristic::PROPERTY_READ | BLECharacteristic::PROPERTY_NOTIFY);
  chStat->addDescriptor(new BLE2902());
  chNets = svc->createCharacteristic(BLE_NETS, BLECharacteristic::PROPERTY_READ | BLECharacteristic::PROPERTY_NOTIFY);
  chNets->addDescriptor(new BLE2902());
  chNets->setValue("[]");
  BLECharacteristic* chInfo = svc->createCharacteristic(BLE_INFO, BLECharacteristic::PROPERTY_READ);
  chInfo->setValue(String("{\"name\":\"") + FLOOR_NAME + "\",\"id\":\"" + stationId + "\",\"fw\":\"" + FW_VERSION + "\",\"path\":\"" + DB_PATH + "\"}");
  svc->start();
  BLEAdvertising* adv = BLEDevice::getAdvertising();
  adv->addServiceUUID(BLE_SVC);
  adv->setScanResponse(true);
  BLEDevice::startAdvertising();
  bleOn = true;
  bleStatus(WiFi.status() == WL_CONNECTED ? "connected" : wifiSsid.length() ? "saved" : "idle");
  Serial.printf("Bluetooth setup ON: %s (open the web page -> Settings -> Set up Wi-Fi)\n", name.c_str());
}

void stopBle() {
  if (!bleOn) return;
  bleOn = false;
  chStat = chNets = nullptr;
  BLEDevice::deinit(true);   // frees the Bluetooth memory for HTTPS
  Serial.println("Bluetooth setup OFF (Wi-Fi is working). Hold RESET at power-on to set up again.");
}

void bleScanNetworks() {
  bleStatus("scanning");
  int n = WiFi.scanNetworks(false, false);
  String j = "[";
  int count = 0;
  for (int i = 0; i < n && count < 12; i++) {
    String ss = WiFi.SSID(i);
    if (ss.length() == 0 || ss.indexOf('"') >= 0 || ss.indexOf('\\') >= 0) continue;
    bool dup = false;
    for (int k = 0; k < i; k++) if (WiFi.SSID(k) == ss) { dup = true; break; }
    if (dup) continue;
    String item = String(count ? "," : "") + "{\"s\":\"" + ss + "\",\"r\":" + WiFi.RSSI(i) + ",\"l\":" + (WiFi.encryptionType(i) == WIFI_AUTH_OPEN ? 0 : 1) + "}";
    if (j.length() + item.length() > 480) break;
    j += item; count++;
  }
  j += "]";
  WiFi.scanDelete();
  if (chNets) { chNets->setValue(j); chNets->notify(); }
  bleStatus(WiFi.status() == WL_CONNECTED ? "connected" : "scanned");
  Serial.printf("Bluetooth: sent %d Wi-Fi networks\n", count);
}

void loadWifi() {
  wifiPrefs.begin("wifi", false);
  wifiSsid = wifiPrefs.getString("ssid", "");
  wifiPass = wifiPrefs.getString("pass", "");
  if (wifiSsid.length() == 0 && strstr(WIFI_SSID, "YOUR_") == nullptr) { wifiSsid = WIFI_SSID; wifiPass = WIFI_PASSWORD; }
  Serial.println(wifiSsid.length() ? "Wi-Fi: " + wifiSsid : String("Wi-Fi: none saved, use Bluetooth setup"));
}

void networkTask(void*) {
  secureClient.setInsecure();   // simple setup: skip certificate check

  String eventKey[2] = { "", "" };
  uint32_t evTail = 0, handledResets = 0;
  uint32_t lastTraceSent = 0;
  unsigned long lastLive = 0, lastCmd = 0, lastWifiTry = 0, lastConfig = 0;
  bool configLoaded = false;

  WiFi.mode(WIFI_STA);
  WiFi.setHostname(MDNS_NAME);
  if (wifiSsid.length()) WiFi.begin(wifiSsid.c_str(), wifiPass.c_str());
  unsigned long lastAnnounce = 0, connectedAt = 0, tryStart = millis();
  bool wasConnected = false, reportedFail = false;

  for (;;) {
    unsigned long now = millis();

    // ---- Bluetooth Wi-Fi setup requests
    if (bleScanReq) { bleScanReq = false; bleScanNetworks(); }
    if (bleForgetReq) {
      bleForgetReq = false;
      wifiPrefs.remove("ssid"); wifiPrefs.remove("pass");
      wifiSsid = ""; wifiPass = ""; WiFi.disconnect();
      bleStatus("idle");
    }
    if (bleConnectReq) {
      bleConnectReq = false;
      wifiSsid = pendSsid; wifiPass = pendPass;
      wifiPrefs.putString("ssid", wifiSsid); wifiPrefs.putString("pass", wifiPass);
      Serial.println("Bluetooth: new Wi-Fi received: " + wifiSsid);
      WiFi.disconnect(); vTaskDelay(pdMS_TO_TICKS(300));
      WiFi.begin(wifiSsid.c_str(), wifiPass.c_str());
      tryStart = lastWifiTry = now; reportedFail = false; wasConnected = false;
      bleStatus("connecting");
    }

    bool up = WiFi.status() == WL_CONNECTED;
    if (up && !wasConnected) {
      wasConnected = true; connectedAt = now;
      Serial.println("Wi-Fi connected: " + WiFi.localIP().toString());
      bleStatus("connected");
    }
    if (!up && wasConnected) wasConnected = false;
    if (up && bleOn && now - connectedAt > BLE_OFF_AFTER_MS && bleServer && bleServer->getConnectedCount() == 0) stopBle();

    if (!up) {
      if (!reportedFail && wifiSsid.length() && now - tryStart > 20000) { reportedFail = true; bleStatus("failed"); }
      if (wifiSsid.length() && now - lastWifiTry > 10000) { lastWifiTry = now; WiFi.disconnect(); WiFi.begin(wifiSsid.c_str(), wifiPass.c_str()); }
      vTaskDelay(pdMS_TO_TICKS(200));
      continue;
    }

    // ---- Tell the dashboard where this station is
    if (lastAnnounce == 0 || now - lastAnnounce >= 30000) { lastAnnounce = now; announceStation(); }

    // ---- Settings from the web page
    if (!configLoaded || now - lastConfig >= CONFIG_PERIOD_MS) {
      lastConfig = now;
      configLoaded = true;
      readConfig();
    }

    // ---- Events
    while (evTail != evHead) {
      EvMsg m;
      portENTER_CRITICAL(&dataMux); m = evq[evTail % EVQ_LEN]; portEXIT_CRITICAL(&dataMux);
      evTail++;
      if (m.type == EV_START) {
        String body = String("{\"kind\":\"") + kindName(m.kind) + "\",\"test\":" + (m.test ? "true" : "false") +
                      ",\"floor\":\"" + FLOOR_NAME + "\",\"status\":\"active\",\"peak\":" + String(m.peak, 4) +
                      ",\"lpg\":" + String(m.lpg, 0) + ",\"smoke\":" + String(m.smoke, 0) + ",\"co2\":" + String(m.co2, 0) +
                      ",\"start\":{\".sv\":\"timestamp\"}}";
        String resp;
        int code = fbRequest("POST", "/events", body, &resp);
        eventKey[m.kind] = "";
        int p = resp.indexOf("\"name\":\"");
        if (code == 200 && p >= 0) eventKey[m.kind] = resp.substring(p + 8, resp.indexOf('"', p + 8));
        if (!m.test) {
          if (m.kind == K_FIRE) sendAlert(String("QuakeGuard: DANGEROUS AIR on ") + FLOOR_NAME,
                                          "LPG " + String(m.lpg, 0) + " ppm, smoke " + String(m.smoke, 0) + " ppm, CO2 " + String(m.co2, 0) +
                                          " ppm. Exit door open, emergency lights on. Leave through the exit.");
          else sendAlert(String("QuakeGuard: EARTHQUAKE on ") + FLOOR_NAME,
                         "Shaking detected. Drop, cover and hold on. Exit door open, emergency lights on.");
        }
      } else {
        if (eventKey[m.kind].length() > 0) {
          String body = String("{\"status\":\"ended\",\"peak\":") + String(m.peak, 4) +
                        ",\"duration\":" + String(m.dur, 1) + ",\"lpg\":" + String(m.lpg, 0) +
                        ",\"smoke\":" + String(m.smoke, 0) + ",\"co2\":" + String(m.co2, 0) +
                        ",\"end\":{\".sv\":\"timestamp\"}}";
          fbRequest("PATCH", "/events/" + eventKey[m.kind], body, nullptr);
        }
        if (!m.test && m.kind == K_QUAKE) {
          float mmi = mmiFromG(m.peak);
          sendAlert(String("QuakeGuard: shaking stopped on ") + FLOOR_NAME,
                    "Lasted " + String(m.dur, 0) + " s. Peak " + String(m.peak, 3) + " g, intensity " +
                    ROMAN[(int)roundf(mmi)] + ". Expect aftershocks. Door stays open until reset.");
        }
      }
    }

    // ---- After a reset: clear the "I'm safe" list
    if (handledResets != resetCount) {
      handledResets = resetCount;
      fbRequest("DELETE", "/safe", "", nullptr);
    }

    // ---- Live status
    LiveData s;
    float trace[20];
    int traceCount = 0;
    uint32_t seq;
    Settings c;
    portENTER_CRITICAL(&dataMux);
    s = live;
    c = cfg;
    seq = traceSeq;
    uint32_t pending = seq - lastTraceSent;
    if (pending > 20) pending = 20;
    for (uint32_t i = seq - pending; i < seq; i++) trace[traceCount++] = traceRing[i % TRACE_LEN];
    portEXIT_CRITICAL(&dataMux);

    if (now - lastLive >= (s.state == ST_ALARM ? 500UL : 1000UL)) {
      lastLive = now;
      lastTraceSent = seq;
      String t = "[";
      for (int i = 0; i < traceCount; i++) { if (i) t += ","; t += String(trace[i], 4); }
      t += "]";
      auto b = [](bool v) { return v ? "true" : "false"; };
      String body = String("{") +
        "\"fw\":\"" + FW_VERSION + "\"," +
        "\"floor\":\"" + FLOOR_NAME + "\"," +
        "\"state\":\"" + STATE_NAMES[s.state] + "\"," +
        "\"alarm\":" + b(s.state == ST_ALARM || s.state == ST_HOLD) + "," +
        "\"quake\":" + b(s.quake) + ",\"fire\":" + b(s.fire) + ",\"test\":" + b(s.test) + "," +
        "\"shake\":" + String(s.shake, 4) + ",\"gyro\":" + String(s.gyro, 2) + "," +
        "\"sta\":" + String(s.sta, 4) + ",\"ratio\":" + String(s.ratio, 2) + "," +
        "\"peak\":" + String(s.peak, 4) + ",\"peakAll\":" + String(s.peakAll, 4) + "," +
        "\"tilt\":" + String(s.tilt, 2) + "," +
        "\"threshold\":" + String(c.minG, 3) + ",\"staTrig\":" + String(c.staTrig, 2) +
        ",\"staDetrig\":" + String(c.staDetrig, 2) + ",\"minDur\":" + String(c.minDurMs / 1000.0f, 2) + "," +
        "\"airEnabled\":" + b(AIR_SENSORS_INSTALLED) + ",\"lpg\":" + String(s.lpg, 1) + ",\"smoke\":" + String(s.smoke, 1) +
        ",\"co2\":" + String(s.co2, 1) + ",\"airRatio\":" + String(s.airRatio, 3) +
        ",\"mq2\":" + String(s.mq2Raw) + ",\"mq135\":" + String(s.mq135Raw) +
        ",\"lpgLimit\":" + String(c.lpgLimit, 0) + ",\"smokeLimit\":" + String(c.smokeLimit, 0) + ",\"co2Limit\":" + String(c.co2Limit, 0) +
        ",\"gasWarm\":" + b(s.gasWarm) + ",\"silenced\":" + b(s.silenced) + ",\"relayMode\":\"" + RELAY_MODES[relayMode] + "\",\"relayOn\":" + b(relayOn) + "," +
        "\"buzzer\":" + b(s.buzzer) + ",\"led\":" + b(s.led) + ",\"light\":" + b(s.light) + "," +
        "\"door\":\"" + (s.doorOpen ? "open" : "closed") + "\"," +
        "\"sensorOk\":" + b(s.sensorOk) + "," +
        "\"quakes\":" + String(s.quakes) + ",\"fires\":" + String(s.fires) + "," +
        "\"aftershocks\":" + String(s.aftershocks) + ",\"watchLeft\":" + String(s.watchLeftS) + "," +
        "\"uptime\":" + String(now / 1000) + ",\"rssi\":" + String(WiFi.RSSI()) + ",\"heap\":" + String(ESP.getFreeHeap()) + "," +
        "\"traceSeq\":" + String(seq) + ",\"trace\":" + t + "," +
        "\"updated\":{\".sv\":\"timestamp\"}}";
      cloudOk = fbRequest("PUT", "/live", body, nullptr) == 200;
    }

    // ---- Commands from the web page
    if (now - lastCmd >= 1500) {
      lastCmd = now;
      String resp;
      if (fbRequest("GET", "/command", "", &resp) == 200 && resp != "null" && resp.indexOf("none") < 0) {
        if (resp.indexOf("relay") >= 0) cmdRelay = relayModeFrom(resp);
        else if (resp.indexOf("testfire") >= 0) cmdTestFire = true;
        else if (resp.indexOf("test") >= 0) cmdTest = true;
        else if (resp.indexOf("reset") >= 0) cmdReset = true;
        else if (resp.indexOf("calibrate") >= 0) cmdCalibrate = true;
        else if (resp.indexOf("endwatch") >= 0) cmdEndWatch = true;
        else if (resp.indexOf("silence") >= 0) cmdSilence = true;
        fbRequest("PUT", "/command", "\"none\"", nullptr);
      }
    }

    vTaskDelay(pdMS_TO_TICKS(50));
  }
}

// ============================================================================
//                               OLED screen
// ============================================================================
// 128x64 layout (on a 128x128 SH1107 it is centred vertically).
// Monitoring: three pages that rotate — seismograph, air, system.
// Alarm: flashing inverted screen with a moving EXIT arrow.
const int WAVE_N = 92;
float waveF[WAVE_N];
int   waveHead = 0;
int   oy = 0, oledPage = 0;
unsigned long oledPageMs = 0, oledMs = 0;
const char* ROMAN_O[] = { "I", "I", "II", "III", "IV", "V", "VI", "VII", "VIII", "IX", "X" };

void pushWave(float v) { waveF[waveHead] = v; waveHead = (waveHead + 1) % WAVE_N; }

bool i2cPresent(uint8_t a) { Wire.beginTransmission(a); return Wire.endTransmission() == 0; }

void centerStr(int y, const char* t) { oled.drawStr((128 - oled.getStrWidth(t)) / 2, oy + y, t); }

void drawLogo(int x, int y) {        // seismic wave mark
  const int8_t p[][2] = { {0, 6}, {6, 6}, {9, 0}, {13, 12}, {16, 3}, {18, 6}, {24, 6} };
  for (int i = 0; i < 6; i++) oled.drawLine(x + p[i][0], oy + y + p[i][1], x + p[i + 1][0], oy + y + p[i + 1][1]);
}

void drawWifi(int x, int y) {
  int n = 0;
  if (WiFi.status() == WL_CONNECTED) { int r = WiFi.RSSI(); n = r > -60 ? 4 : r > -67 ? 3 : r > -75 ? 2 : 1; }
  for (int i = 0; i < 4; i++) {
    int h = 2 + i * 2;
    if (i < n) oled.drawBox(x + i * 3, oy + y + 8 - h, 2, h);
    else oled.drawPixel(x + i * 3, oy + y + 7);
  }
}

void drawCloud(int x, int y) {       // filled = Firebase OK, crossed = offline
  if (cloudOk) {
    oled.drawDisc(x + 3, oy + y + 5, 2); oled.drawDisc(x + 6, oy + y + 3, 3); oled.drawDisc(x + 9, oy + y + 5, 2);
    oled.drawBox(x + 3, oy + y + 5, 7, 3);
  } else {
    oled.drawCircle(x + 6, oy + y + 4, 3); oled.drawLine(x + 2, oy + y + 8, x + 10, oy + y);
  }
}

void topBar(const char* title) {
  oled.setFont(u8g2_font_6x10_tr);
  oled.drawStr(0, oy + 8, title);
  for (int i = 0; i < 3; i++) {
    int x = 84 + i * 5;
    if (i == oledPage) oled.drawBox(x - 1, oy + 3, 3, 3); else oled.drawPixel(x, oy + 4);
  }
  drawWifi(102, 0);
  drawCloud(115, 0);
  oled.drawHLine(0, oy + 11, 128);
}

void bar(int x, int y, int w, int h, float f) {
  f = fminf(1.0f, fmaxf(0.0f, f));
  oled.drawRFrame(x, oy + y, w, h, 2);
  int fw = (int)((w - 4) * f);
  if (fw > 0) oled.drawBox(x + 2, oy + y + 2, fw, h - 4);
}

void pageSeismo(float minG) {
  topBar("SEISMO");
  if (!sensorOk) {
    oled.setFont(u8g2_font_6x10_tr);
    centerStr(30, "MPU6050 not found");
    centerStr(44, "Check SDA 21 / SCL 22");
    return;
  }
  float scale = minG * 2;
  for (int i = 0; i < WAVE_N; i++) scale = fmaxf(scale, waveF[i] * 1.1f);
  const int mid = oy + 37, half = 22;
  for (int i = 0; i < WAVE_N; i++) {               // mirrored envelope, newest on the right
    int h = (int)fminf(half, waveF[(waveHead + i) % WAVE_N] / scale * half);
    oled.drawVLine(i, mid - h, 2 * h + 1);
  }
  int ty = (int)(minG / scale * half);
  for (int x = 0; x < WAVE_N; x += 4) { oled.drawPixel(x, mid - ty); oled.drawPixel(x, mid + ty); }  // alarm level
  // intensity box
  int m = (int)roundf(mmiFromG(shakeAvg < 0.005f ? 0 : shakeAvg));
  if (shakeAvg < 0.005f) m = 1;
  oled.drawRBox(96, oy + 15, 32, 24, 3);
  oled.setDrawColor(0);
  oled.setFont(u8g2_font_helvB12_tr);
  oled.drawStr(112 - oled.getStrWidth(ROMAN_O[m]) / 2, oy + 33, ROMAN_O[m]);
  oled.setDrawColor(1);
  oled.setFont(u8g2_font_5x7_tr);
  oled.drawStr(101, oy + 47, "MMI");
  char b[12]; snprintf(b, sizeof(b), "%.3fg", shakeAvg);
  oled.drawStr(128 - oled.getStrWidth(b), oy + 57, b);
  if ((long)(watchUntilMs - millis()) > 0) oled.drawStr(0, oy + 64, "AFTERSHOCK WATCH");
}

void pageAir(const Settings& c) {
  topBar("AIR");
  oled.setFont(u8g2_font_6x10_tr);
  if (!AIR_SENSORS_INSTALLED) { centerStr(36, "No air sensors"); return; }
  if (millis() < GAS_WARMUP_MS) {
    centerStr(30, "Warming up sensors");
    bar(14, 38, 100, 10, millis() / (float)GAS_WARMUP_MS);
    char b[16]; snprintf(b, sizeof(b), "%lus left", (GAS_WARMUP_MS - millis()) / 1000 + 1);
    centerStr(60, b);
    return;
  }
  const char* n[] = { "LPG", "SMK", "CO2" };
  float v[] = { lpg, smoke, co2 }, lim[] = { c.lpgLimit, c.smokeLimit, c.co2Limit };
  for (int i = 0; i < 3; i++) {
    int y = 15 + i * 17;
    oled.drawStr(0, oy + y + 8, n[i]);
    float r = v[i] / lim[i];
    bar(24, y, 70, 10, r / 1.25f);
    int tx = 24 + 2 + (int)(66 / 1.25f);           // alarm limit tick
    oled.drawVLine(tx, oy + y - 2, 14);
    char b[8]; snprintf(b, sizeof(b), "%d", (int)v[i]);
    oled.drawStr(128 - oled.getStrWidth(b), oy + y + 8, b);
    if (r >= 1 && (millis() / 300) % 2) oled.drawFrame(0, oy + y - 1, 22, 12);   // blink when over
  }
}

void pageSystem() {
  topBar("SYSTEM");
  oled.setFont(u8g2_font_6x10_tr);
  char b[24];
  snprintf(b, sizeof(b), "Tilt    %.2f deg", tiltDegrees()); oled.drawStr(0, oy + 23, b);
  unsigned long s = millis() / 1000;
  snprintf(b, sizeof(b), "Up      %luh %02lum", s / 3600, (s / 60) % 60); oled.drawStr(0, oy + 34, b);
  snprintf(b, sizeof(b), "Quakes %lu  Air %lu", (unsigned long)quakeCount, (unsigned long)fireCount); oled.drawStr(0, oy + 45, b);
  if (WiFi.status() == WL_CONNECTED) oled.drawStr(0, oy + 57, WiFi.localIP().toString().c_str());
  else oled.drawStr(0, oy + 57, "Wi-Fi: connecting");
  oled.setFont(u8g2_font_5x7_tr);
  oled.drawStr(128 - oled.getStrWidth(FLOOR_NAME), oy + 57, FLOOR_NAME);
}

void screenAlarm(unsigned long now) {
  bool fire = fireActive || (testActive && testKind == K_FIRE);
  bool inv = (now / 400) % 2;
  if (inv) { oled.drawBox(0, oy, 128, 64); oled.setDrawColor(0); }
  oled.setFont(u8g2_font_helvB12_tr);
  centerStr(16, testActive ? "TEST ALARM" : fire ? "BAD AIR!" : "EARTHQUAKE!");
  oled.setFont(u8g2_font_6x10_tr);
  char b[24];
  if (fire) {
    const char* n = "LPG"; float v = lpg, r = lpg / cfg.lpgLimit;
    if (smoke / cfg.smokeLimit > r) { n = "SMOKE"; v = smoke; r = smoke / cfg.smokeLimit; }
    if (co2 / cfg.co2Limit > r) { n = "CO2"; v = co2; }
    snprintf(b, sizeof(b), "%s %d ppm", n, (int)v);
  } else {
    float pk = quakePeak > 0 ? quakePeak : shakeAvg;
    snprintf(b, sizeof(b), "MMI %s  %.2f g", ROMAN_O[(int)roundf(mmiFromG(pk))], pk);
  }
  centerStr(30, b);
  centerStr(42, silenced ? "Buzzer silenced" : "Door open, go out");
  // moving EXIT arrow
  oled.setFont(u8g2_font_6x10_tr);
  oled.drawStr(2, oy + 61, "EXIT");
  int o = (now / 60) % 16;
  for (int k = 0; k < 5; k++) {
    int x = 32 + k * 16 + o;
    if (x > 120) continue;
    oled.drawTriangle(x, oy + 51, x, oy + 63, x + 7, oy + 57);
  }
  oled.setDrawColor(1);
}

void screenHold() {
  oled.drawRFrame(0, oy, 128, 64, 4);
  oled.setFont(u8g2_font_helvB10_tr);
  centerStr(16, lastWasFire ? "AIR CLEARED" : "SHAKING STOPPED");
  oled.setFont(u8g2_font_6x10_tr);
  centerStr(31, "Door open, lights on");
  centerStr(43, "Press RESET when");
  centerStr(55, "the area is safe");
}

void oledCalib(int pct) {
  if (!oledOk) return;
  oled.clearBuffer();
  drawLogo(52, 6);
  oled.setFont(u8g2_font_helvB10_tr);
  centerStr(36, "Calibrating");
  oled.setFont(u8g2_font_5x7_tr);
  centerStr(46, "keep the station still");
  bar(14, 52, 100, 9, pct / 100.0f);
  oled.sendBuffer();
}

void oledSplash() {
  if (!oledOk) return;
  oled.clearBuffer();
  drawLogo(52, 4);
  oled.setFont(u8g2_font_helvB12_tr);
  centerStr(36, "QuakeGuard");
  oled.setFont(u8g2_font_5x7_tr);
  centerStr(48, "Earthquake + air alarm");
  centerStr(60, "HBRT Afghan-Turk");
  oled.sendBuffer();
}

void oledUpdate(unsigned long now, State st, float minG) {
  if (!oledOk || now - oledMs < 200) return;      // 5 frames per second
  oledMs = now;
  if (st == ST_MONITOR && now - oledPageMs >= OLED_PAGE_MS) { oledPageMs = now; oledPage = (oledPage + 1) % 3; }
  if (st != ST_MONITOR) oledPage = 0;
  Settings c; portENTER_CRITICAL(&dataMux); c = cfg; portEXIT_CRITICAL(&dataMux);
  oled.clearBuffer();
  if (st == ST_ALARM) screenAlarm(now);
  else if (st == ST_HOLD) screenHold();
  else if (oledPage == 0) pageSeismo(minG);
  else if (oledPage == 1) pageAir(c);
  else pageSystem();
  oled.sendBuffer();
}

// ============================================================================
//                                 Setup
// ============================================================================
void setup() {
  Serial.begin(115200);
  delay(300);
  Serial.printf("\n=== QuakeGuard v%s — %s ===\n", FW_VERSION, FLOOR_NAME);

  pinMode(PIN_RELAY, OUTPUT);
  setRelay(false);                     // OFF from the start (HIGH), like the test sketch
  if (RELAY_BOOT_TEST) {               // same as the relay test sketch: LOW (ON) 1 s, HIGH (OFF) 1 s
    for (int i = 1; i <= RELAY_TEST_TIMES; i++) {
      Serial.printf("Relay test %d/%d\n", i, RELAY_TEST_TIMES);
      setRelay(true);  delay(1000);
      setRelay(false); delay(1000);
    }
  }
  pinMode(PIN_BUZZER_1, OUTPUT);
  pinMode(PIN_BUZZER_2, OUTPUT);
  pinMode(PIN_LED, OUTPUT);
  pinMode(PIN_RESET_BTN, INPUT_PULLUP);
  setBuzzers(false);
  digitalWrite(PIN_LED, LOW);
  analogReadResolution(12);
  if (AIR_SENSORS_INSTALLED) { analogSetPinAttenuation(PIN_MQ2, ADC_11db); analogSetPinAttenuation(PIN_MQ135, ADC_11db); }

  ESP32PWM::allocateTimer(0);
  doorServo.setPeriodHertz(50);
  doorServo.attach(PIN_SERVO, 500, 2400);
  doorServo.write(DOOR_CLOSED_ANGLE);
  doorIsOpen = false;

  setBuzzers(true); delay(120); setBuzzers(false);   // power-on beep

  Wire.begin(PIN_SDA, PIN_SCL);
  if (OLED_ENABLED && (i2cPresent(0x3C) || i2cPresent(0x3D))) {
    oled.setBusClock(400000);
    oledOk = oled.begin();
    oy = (oled.getDisplayHeight() - 64) / 2;
    oledSplash();
    delay(1500);
  }
  Serial.println(oledOk ? "OLED: found" : "OLED: not found (or disabled)");

  sensorOk = mpuBegin();
  if (!sensorOk) Serial.println("ERROR: MPU6050 not found. Check SDA=21, SCL=22, VCC=3.3V, GND.");
  else calibrate();

  live.state = ST_MONITOR;
  live.sensorOk = sensorOk;
  live.gasWarm = AIR_SENSORS_INSTALLED;
  windowStartMs = millis();

  char sid[16]; snprintf(sid, sizeof(sid), "qg-%06llx", ESP.getEfuseMac() & 0xFFFFFFULL);
  stationId = sid;
  loadWifi();
  if (digitalRead(PIN_RESET_BTN) == LOW) {            // RESET held at power-on: forget Wi-Fi
    wifiPrefs.remove("ssid"); wifiPrefs.remove("pass"); wifiSsid = ""; wifiPass = "";
    Serial.println("RESET held: saved Wi-Fi forgotten. Use Bluetooth setup.");
    setBuzzers(true); delay(80); setBuzzers(false); delay(80); setBuzzers(true); delay(80); setBuzzers(false);
  }
  startBle();
  if (cloudConfigured()) {
    xTaskCreatePinnedToCore(networkTask, "network", 16384, nullptr, 1, nullptr, 0);
    xTaskCreatePinnedToCore(serverTask, "web", 8192, nullptr, 1, nullptr, 0);
    Serial.println("Cloud sync: ON (Firebase)");
  } else {
    Serial.println("Cloud sync: OFF — set Wi-Fi and Firebase in USER SETTINGS. Alarm still works.");
  }
  Serial.println("Monitoring...");
}

// ============================================================================
//                         Main loop (core 1, 100 Hz)
// ============================================================================
void loop() {
  static unsigned long lastSample = 0, lastDebug = 0, btnDownMs = 0, lastSensorRetry = 0, lastGasRead = 0;
  static int readFails = 0;

  unsigned long now = millis();
  if (now - lastSample < SAMPLE_PERIOD_MS) return;
  lastSample = now;

  Settings c;
  portENTER_CRITICAL(&dataMux); c = cfg; portEXIT_CRITICAL(&dataMux);
  bool watch = (long)(watchUntilMs - now) > 0;
  float minG = c.minG * (watch ? AFTERSHOCK_FACTOR : 1.0f);

  // ---------- Motion sensor
  float ax, ay, az, gx, gy, gz;
  float shakeNow = 0, gyroNow = 0;
  if (sensorOk && mpuRead(ax, ay, az, gx, gy, gz)) {
    readFails = 0;
    float dx = ax - baseX, dy = ay - baseY, dz = az - baseZ;
    shakeNow = sqrtf(dx * dx + dy * dy + dz * dz);
    float rx = gx - gyroOffX, ry = gy - gyroOffY, rz = gz - gyroOffZ;
    gyroNow = sqrtf(rx * rx + ry * ry + rz * rz);
    shakeFast += 0.25f * (shakeNow - shakeFast);   // for peak values
    shakeAvg  += 0.08f * (shakeNow - shakeAvg);    // ~0.25 s
    gyroAvg   += 0.08f * (gyroNow - gyroAvg);
    sta       += STA_ALPHA * (shakeNow - sta);     // 1 s
    if (!quakeActive && trigStartMs == 0) {
      lta += LTA_ALPHA * (shakeNow - lta);         // 30 s, frozen while triggered
      if (shakeAvg < minG * 0.5f) {                // follow gravity slowly when calm
        baseX += 0.002f * (ax - baseX);
        baseY += 0.002f * (ay - baseY);
        baseZ += 0.002f * (az - baseZ);
      }
    }
  } else if (sensorOk) {
    if (++readFails > 50) { sensorOk = false; Serial.println("ERROR: lost connection to MPU6050"); }
  } else if (now - lastSensorRetry > 3000) {
    lastSensorRetry = now;
    if (mpuBegin()) { sensorOk = true; calibrate(); }
  }
  float ratio = sta / fmaxf(lta, NOISE_FLOOR_G);

  // ---------- Earthquake detection (STA/LTA + minimum g + duration)
  bool trig = sensorOk && ((ratio >= c.staTrig && sta >= minG) ||
                           shakeAvg >= minG * 3.0f ||
                           gyroAvg >= c.gyroDps);
  if ((long)(ignoreUntilMs - now) > 0) trig = false;
  if (trig) {
    if (trigStartMs == 0) trigStartMs = now;
    if (!quakeActive && now - trigStartMs >= c.minDurMs) startQuake(now);
  } else {
    trigStartMs = 0;
  }
  if (quakeActive) {
    bool still = (ratio >= c.staDetrig && sta >= minG * 0.5f) || shakeAvg >= minG || gyroAvg >= c.gyroDps * 0.6f;
    if (still) lastShakeMs = now;
    if (shakeFast > quakePeak) quakePeak = shakeFast;
    if (quakePeak > peakAll) peakAll = quakePeak;
    if (now - lastShakeMs >= c.quietMs || now - quakeStartMs >= MAX_QUAKE_MS) endQuake(now);
  }

  // ---------- Air quality (MQ-2 + MQ-135), same estimates as the Air Monitor project
  bool gasWarm = false;
  if (AIR_SENSORS_INSTALLED) {
    if (now - lastGasRead >= 100) {
      lastGasRead = now;
      long s2 = 0, s135 = 0;
      for (int i = 0; i < 10; i++) { s2 += analogRead(PIN_MQ2); s135 += analogRead(PIN_MQ135); }
      mq2Raw = s2 / 10; mq135Raw = s135 / 10;
      // simple estimates from the raw readings (not calibrated ppm)
      lpg   = (mq2Raw / 4095.0f) * 1000.0f;
      smoke = (mq2Raw / 4095.0f) * 800.0f;
      co2   = 400.0f + (mq135Raw / 4095.0f) * 1600.0f;
      airRatio = fmaxf(lpg / c.lpgLimit, fmaxf(smoke / c.smokeLimit, co2 / c.co2Limit));
    }
    gasWarm = now < GAS_WARMUP_MS;
    bool gasHigh = !gasWarm && airRatio >= 1.0f;
    if (gasHigh && (long)(ignoreUntilMs - now) <= 0) {
      if (fireCondMs == 0) fireCondMs = now;
      if (!fireActive && now - fireCondMs >= GAS_CONFIRM_MS) startFire(now);
    } else if (!gasHigh) {
      fireCondMs = 0;
    }
    if (fireActive) {
      if (airRatio > 0.9f) lastFireMs = now;
      peakLpg = fmaxf(peakLpg, lpg); peakSmoke = fmaxf(peakSmoke, smoke); peakCo2 = fmaxf(peakCo2, co2);
      if (now - lastFireMs >= c.quietMs) endFire(now);
    }
  }

  // ---------- Test alarm
  if (testActive && now >= testEndMs) endTest(now);

  // ---------- Reset button
  if (digitalRead(PIN_RESET_BTN) == LOW) {
    if (btnDownMs == 0) btnDownMs = now;
    if (now - btnDownMs > 50 && currentState() != ST_MONITOR) resetSystem(now);
  } else {
    btnDownMs = 0;
  }

  // ---------- Commands from the web page
  if (cmdReset)    { cmdReset = false;    if (currentState() != ST_MONITOR) resetSystem(now); }
  if (cmdTest)     { cmdTest = false;     startTest(now, K_QUAKE); }
  if (cmdTestFire) { cmdTestFire = false; startTest(now, K_FIRE); }
  if (cmdEndWatch) { cmdEndWatch = false; watchUntilMs = now; aftershockCount = 0; }
  if (cmdSilence)  { cmdSilence = false;  if (currentState() == ST_ALARM) silenced = true; }
  if (cmdRelay >= 0) { relayMode = (RelayMode)cmdRelay; cmdRelay = -1; Serial.printf("Relay mode: %s\n", RELAY_MODES[relayMode]); }
  if (Serial.available()) {            // Serial Monitor: relay on / relay off / relay auto / relay test
    String c = Serial.readStringUntil('\n'); c.trim(); c.toLowerCase();
    int m = c.startsWith("relay") ? relayModeFrom(c) : -1;
    if (m >= 0) cmdRelay = m; else if (c.length()) Serial.println("Type: relay on, relay off, relay auto, relay test");
  }
  if (cmdCalibrate) {
    cmdCalibrate = false;
    if (currentState() == ST_MONITOR && sensorOk) { calibrate(); now = millis(); ignoreUntilMs = now + RESET_IGNORE_MS; }
  }

  // ---------- Outputs
  State st = currentState();
  bool alarm = (st == ST_ALARM), hold = (st == ST_HOLD);
  bool fireSiren = fireActive || (testActive && testKind == K_FIRE);
  if (!alarm) silenced = false;
  bool buzzerOn = alarm && !silenced && (fireSiren ? ((now / 150) % 2 == 0) : ((now / 250) % 3 != 2));
  setBuzzers(buzzerOn);
  digitalWrite(PIN_LED, (alarm || hold) ? HIGH : LOW);
  // AUTO: light ON only for a strong earthquake (peak >= relayMinG), dangerous air or a test,
  // and OFF again relayHold seconds after the alarm ends (no longer waits for reset).
  static bool relayLatched = false;
  static unsigned long relayOffAt = 0;
  auto extend = [&](unsigned long t) { if (!relayLatched || (long)(t - relayOffAt) > 0) relayOffAt = t; relayLatched = true; };
  if (quakeActive && quakePeak >= cfg.relayMinG) extend(lastShakeMs + cfg.relayHoldMs);   // 20 s after the last shaking
  if (fireActive) extend(lastFireMs + cfg.relayHoldMs);
  if (testActive) extend(now + 200);                                                        // tests: only while testing
  if (relayLatched && (long)(now - relayOffAt) >= 0) relayLatched = false;
  if (!alarm && !hold) relayLatched = false;                                                // reset = off at once
  bool want = relayLatched;
  if (relayMode == RM_ON) want = true;
  else if (relayMode == RM_OFF) want = false;
  else if (relayMode == RM_TEST) want = (now / 2000) % 2 == 0;
  setRelay(want);
  setDoor(alarm || hold, now);

  // ---------- Seismograph trace (max of each 100 ms window)
  if (shakeNow > windowMax) windowMax = shakeNow;
  bool windowDone = now - windowStartMs >= TRACE_WINDOW_MS;
  float tilt = windowDone ? tiltDegrees() : live.tilt;

  portENTER_CRITICAL(&dataMux);
  live.state = st;
  live.quake = quakeActive || (testActive && testKind == K_QUAKE);
  live.fire  = fireActive  || (testActive && testKind == K_FIRE);
  live.test  = testActive;
  live.latched = latched;
  live.shake = shakeAvg;   live.gyro = gyroAvg;
  live.sta = sta;          live.ratio = ratio;
  live.peak = quakePeak;   live.peakAll = peakAll;
  live.tilt = tilt;
  live.lpg = lpg; live.smoke = smoke; live.co2 = co2; live.airRatio = airRatio;
  live.mq2Raw = mq2Raw; live.mq135Raw = mq135Raw;
  live.gasWarm = gasWarm;  live.silenced = silenced;
  live.buzzer = alarm && !silenced;     live.led = alarm || hold;  live.light = relayOn;
  live.doorOpen = doorIsOpen;
  live.sensorOk = sensorOk;
  live.quakes = quakeCount; live.fires = fireCount; live.aftershocks = aftershockCount;
  live.watchLeftS = watch ? (long)((watchUntilMs - now) / 1000) : 0;
  if (windowDone) { traceRing[traceSeq % TRACE_LEN] = windowMax; traceSeq++; }
  portEXIT_CRITICAL(&dataMux);
  if (windowDone) { pushWave(windowMax); windowMax = 0; windowStartMs = now; }

  // ---------- OLED
  oledUpdate(now, st, minG);

  // ---------- Serial output for tuning
  if (DEBUG_SERIAL && now - lastDebug >= 250) {
    lastDebug = now;
    Serial.printf("shake=%.4f g  sta=%.4f  ratio=%5.2f  gyro=%6.2f  tilt=%.2f  LPG=%.0f smoke=%.0f CO2=%.0f  state=%s\n",
                  shakeAvg, sta, ratio, gyroAvg, tilt, lpg, smoke, co2, STATE_NAMES[st]);
  }
}
