mostafaaabedia-tech/earthquake/(commit log)

2026-10-25 Add ESP32 earthquake detection system and live web page
    - MPU6050 detection, 2 buzzers, LED, servo door, relay light, reset button
    - Firebase sync on core 0 so the alarm never waits for Wi-Fi
    - Formal GitHub Pages dashboard with seismograph, event log, reset/test
    - README with wiring, Firebase and Pages setup
    Claude-Session: https://claude.ai/code/session_01J8KD7ciAZRSNvabPSzXoub
    [earthquake_esp32.ino]
2026-10-26 QuakeGuard v2: new dashboard design, region map and smarter detection
    Web page (QuakeGuard design):
    - Tabs: Dashboard, Live Map, Region, History, Settings
    - Animated floor plan with corridor lights, stair door, evacuation route, tap-your-room
    - Full-screen alarm, voice, vibration, siren, I'm safe counter, multi-floor
    - Regional earthquake map (USGS + EMSC fallback, Leaflet/OSM)
    - Mercalli intensity gauge, STA/LTA chart, USGS catalog check, CSV/JSON export
    - Remote detector settings, calibration, aftershock watch, sensor health
    - Emergency contacts, manager PIN, Dari/RTL, PWA, QR code, printable plan
    - Demo mode until config.js has a Firebase URL
    Firmware v2:
    - STA/LTA trigger with minimum g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
    [earthquake_esp32.ino]
2026-10-26 Connect to Firebase project quakeguard-earthquake
    - config.js and ESP32 firmware now use the europe-west1 Realtime Database
    - README documents the project, database URL and rules
    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
2026-10-26 Floor map from the real model, plus animations and UI polish
    - Floor plan redrawn from the physical model: 5 rooms each side of a long
    corridor, door swings, windows with red awnings, exit at the corridor end,
    outside assembly point; tap any of the 10 rooms for its route
    - Animations: walls draw in on load, light sweep toward the exit, glowing
    doors, flickering flame, triple seismic ripples, people walking to the
    assembly point, live-status pulse, scanning status wave
    - Polished cards, gradient buttons, sensor icons coloured by state
    - Wording: "exit" instead of "stairs" (English and Dari)
    Claude-Session: https://claude.ai/code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
2026-10-26 Fix stale-cache mix-up and polish the dashboard
    - Versioned asset links (?v=4) and no-cache service worker fetches, so the
    browser never mixes an old app.js with the new page
    - Station card (online dot, signal bars, uptime, last update)
    - Map legend under the floor plan
    - Sticky blurred header with accent line, glowing status banner
    - Gas card shows a dash when no sensor is installed
    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
2026-10-27 Add MQ-2 + MQ-135 air sensors and the Air Monitor page
    Firmware:
    - MQ-2 (GPIO 34) and MQ-135 (GPIO 35) with the Air Monitor's LPG, smoke
    and CO2 estimates; dangerous air triggers the evacuation alarm
    - LPG/smoke/CO2 limits read from Firebase; "silence" command stops the
    buzzers only; events and Telegram/ntfy carry the gas peaks
    Web page:
    - New Air tab: headline, three dial gauges, silence button, particle
    background, 10-minute gas trend, city PM2.5 and weather, team credits
    - Dashboard air-quality card, Silence button in Controls, MQ-2/MQ-135
    health rows, gas limits in Detector settings, gas columns in CSV
    - English and Dari text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
    [earthquake_esp32.ino]
2026-10-28 Add OLED screen (SSD1306/SH1106/SH1107) with seismograph, air and system pages
    - Boot splash and calibration progress screens
    - Rotating SEISMO / AIR / SYSTEM pages with Wi-Fi bars and cloud status
    - Flashing alarm screen with intensity or worst gas and a moving EXIT arrow
    - Hold screen after the alarm; README wiring and library notes
    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
2026-10-31 Add Find stations (radar search, local IPs) and a local ESP32 page
    - Firmware 2.1: announces itself in earthquake/stations every 30 s, serves
    a local status page with Silence/Reset at http://<ip>/ and quakeguard.local
    - Dashboard: Find stations card with radar animation, progress, result cards
    (online, signal, IP, firmware), Open / Local page / Copy IP, open by IP
    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
    [earthquake_esp32.ino]
2026-10-31 OLED: SH1107 128x128 without the 96 px offset (fixes shifted picture)
    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
    [earthquake_esp32.ino]
2026-11-02 Light relay: same driving as the working test sketch, plus Auto/On/Off/Test
    - GPIO 14: LOW = ON, HIGH = OFF; boot self-test (ON 1 s, then OFF)
    - Relay modes from the dashboard (PIN), local page, Firebase command and Serial
    - Dashboard shows the real relay state
    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
2026-11-02 Simpler, responsive dashboard
    - Phones/tablets: app-style bottom tab bar with icons; desktop tabs get icons
    - Dashboard: status, 4 at-a-glance tiles (shaking, air, exit door, light),
    floor plan, controls, people, steps; details moved to History/Settings
    - One-line hint under each tab; steps jump to the top during an alarm
    - Controls grouped (Alarm / Try it / Light relay); sound toggle in Settings
    - Single floor: no floor picker or side column; two-column desktop layout
    - Floor plan stays readable on phones (scrolls sideways)
    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
2026-11-03 Relay only for strong shaking, off 20 s after; new Fault Line theme
    - AUTO light relay: needs peak >= relayMinG (0.06 g), turns off relayHold
    (20 s) after the last shaking; both editable in Detector settings
    - Website theme: basalt + magma colors, topographic and grain textures,
    seismograph header with glowing fault crack, condensed headings,
    textured cards, shaking status banner during an earthquake
    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
    [earthquake_esp32.ino]
2026-11-03 Wi-Fi setup by Bluetooth from the web page
    - Firmware: BLE service (scan networks, send name/password, live status),
    Wi-Fi saved in flash, RESET held at power-on forgets it, BLE turns off
    5 min after Wi-Fi connects; needs Huge APP partition scheme
    - Web page: Settings card with Connect / network list / password / Save,
    live status, demo walkthrough, and a 'Set up Wi-Fi' shortcut when offline
    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
    [earthquake_esp32.ino]
2026-11-03 Relay boot test: 3 ON/OFF clicks
    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
